CarlosG340/iot_microneedle_leaf_sensor_patch/Final Showcase.jpg

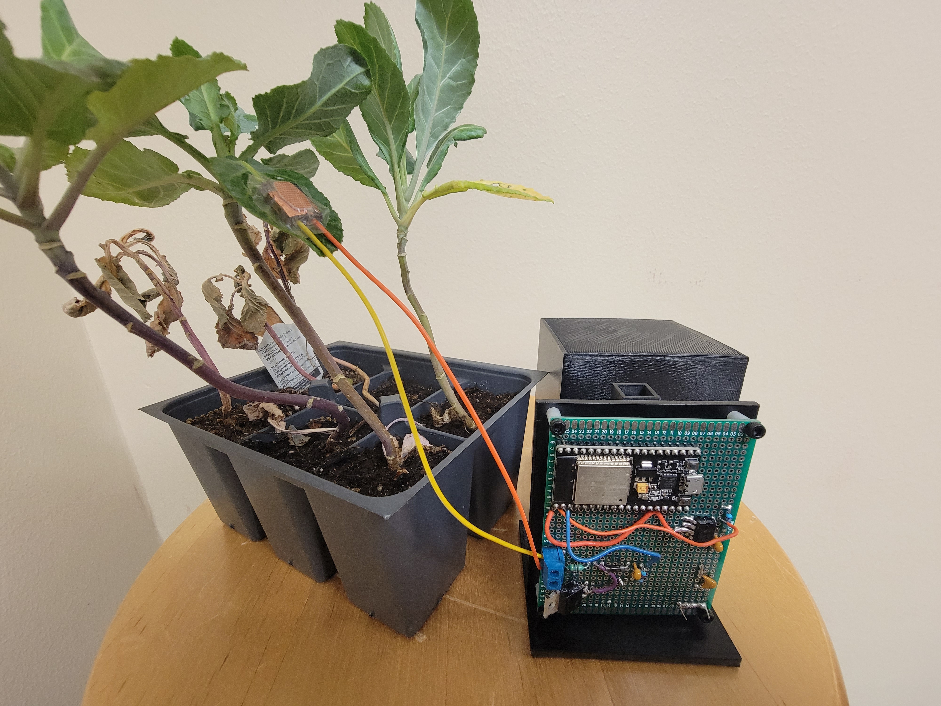
Final Showcase.jpg
