CarlosG340/iot_microneedle_leaf_sensor_patch/20220418_203752.jpg

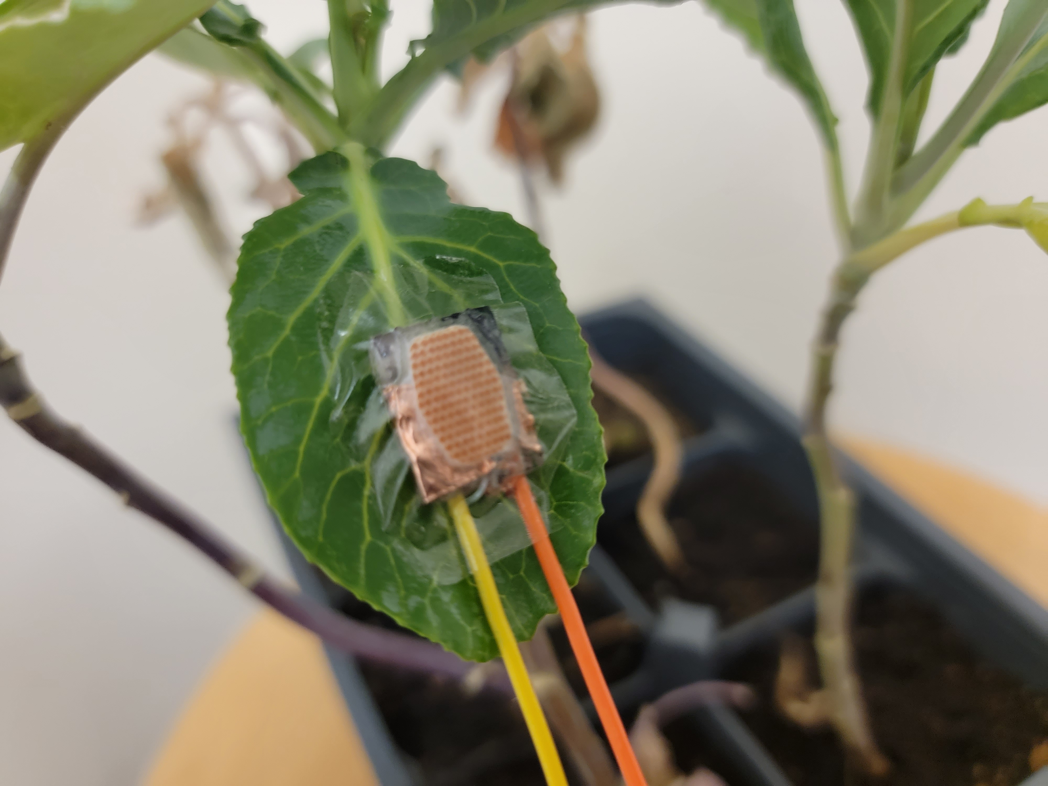
20220418_203752.jpg
