CarlosG340/iot_microneedle_leaf_sensor_patch/All_Patch_Prototype.jpg

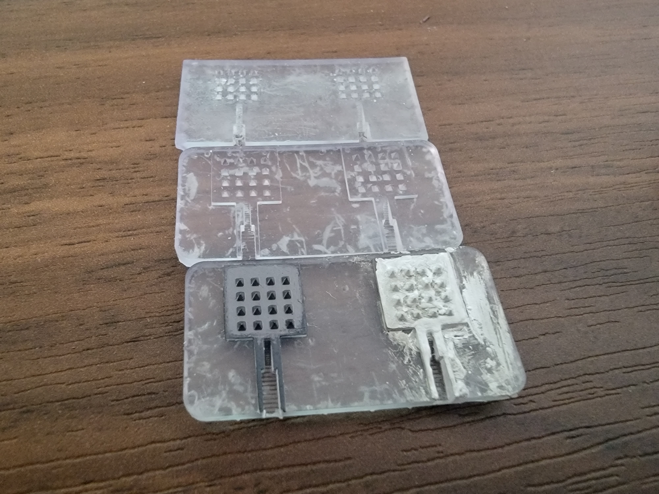
All_Patch_Prototype.jpg
