CarlosG340/iot_microneedle_leaf_sensor_patch/Patch_Prototype_1.jpg

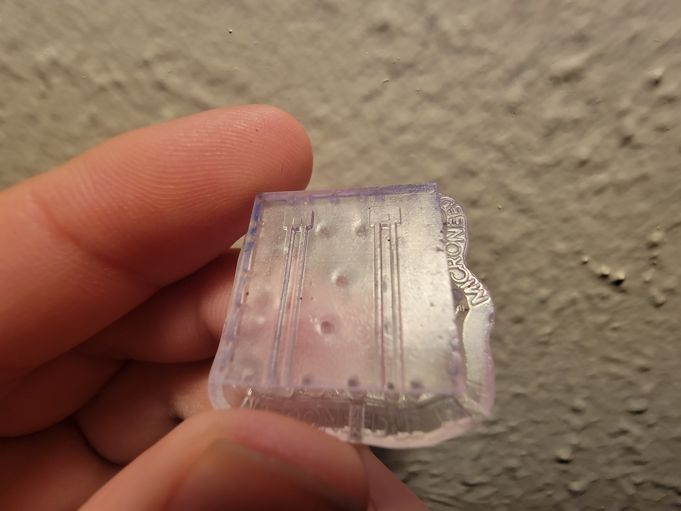
Patch_Prototype_1.jpg
