CarlosG340/iot_microneedle_leaf_sensor_patch/Patch_Prototype_2.2.jpg

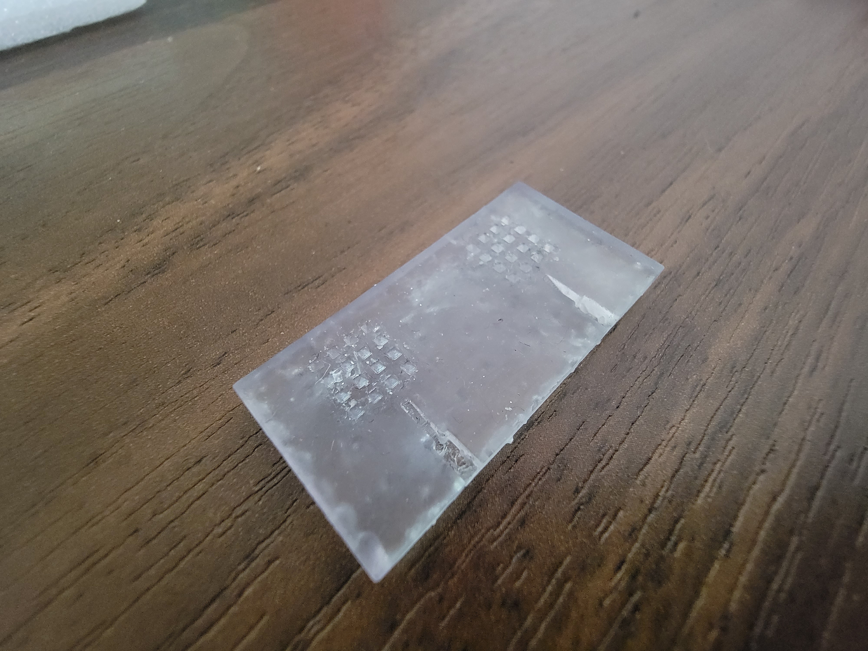
Patch_Prototype_2.2.jpg
