CarlosG340/iot_microneedle_leaf_sensor_patch/Patch_Prototyper_2.1.jpg

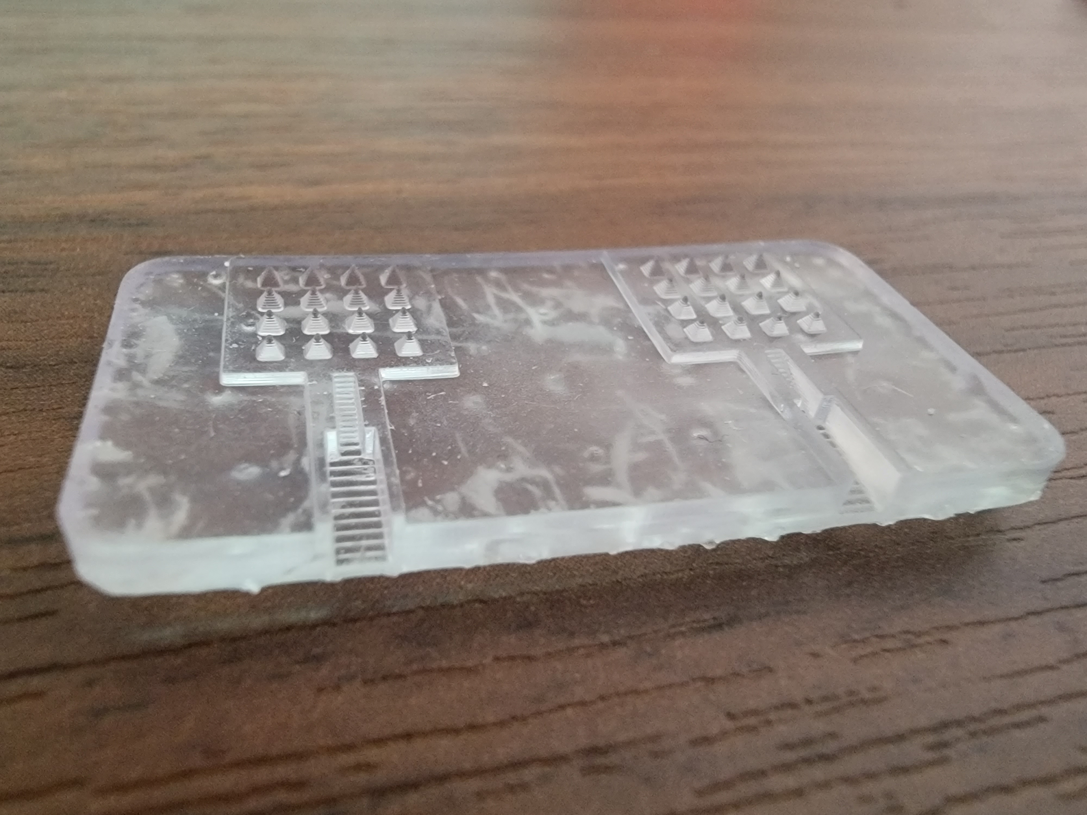
Patch_Prototyper_2.1.jpg
