CarlosG340/iot_microneedle_leaf_sensor_patch/pH_Test_Results.xlsx

Sheet: PANI Deposition
-0.199853 | -8.539962 | -8.45456238 | -8.36916276 | -8.28376314 | -8.19836352 | -8.1129639 | -9.686276 | -9.58941324 | -9.49255048 | -9.39568772 | -9.29882496 | -9.2019622 | -10.034594 | -9.93424806 | -9.83390212 | -9.73355618 | -9.63321024 | -9.5328643 | -10.242354 | -10.13993046 | -10.03750692 | -9.93508338 | -9.83265984 | -9.7302363 | -10.410912 | -10.30680288 | -10.20269376 | -10.09858464 | -9.99447552 | -9.8903664 | -10.545872 | -10.44041328 | -10.33495456 | -10.22949584 | -10.12403712 | -10.0185784 | -10.634912 | -10.52856288 | -10.42221376 | -10.31586464 | -10.20951552 | -10.1031664 | -10.723392 | -10.61615808 | -10.50892416 | -10.40169024 | -10.29445632 | -10.1872224 | -10.792832 | -10.68490368 | -10.57697536 | -10.46904704 | -10.36111872 | -10.2531904
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
