CarlosG340/iot_microneedle_leaf_sensor_patch/SecureWrite2.ino

#if defined(ESP32)
#include <WiFiMulti.h>
WiFiMulti wifiMulti;
#define DEVICE "ESP32"
#elif defined(ESP8266)
#include <ESP8266WiFiMulti.h>
ESP8266WiFiMulti wifiMulti;
#define DEVICE "ESP8266"
#endif

#include <InfluxDbClient.h>
#include <InfluxDbCloud.h>

const int numReadings = 10;

int readings[numReadings];      // the readings from the analog input
int readIndex = 0;              // the index of the current reading
int total = 0;                  // the running total
int average = 0;                // the average

int inputPin = A0;

// My stuff
int readPin=32;
int readVal;
int newReadVal;
float voltage_test1;
float finalReading;

// WiFi AP SSID
#define WIFI_SSID "Carlos wifi"
// WiFi password
#define WIFI_PASSWORD "carlos124"
// InfluxDB v2 server url, e.g. https://eu-central-1-1.aws.cloud2.influxdata.com (Use: InfluxDB UI -> Load Data -> Client Libraries)
#define INFLUXDB_URL "https://us-east-1-1.aws.cloud2.influxdata.com"
// InfluxDB v2 server or cloud API authentication token (Use: InfluxDB UI -> Load Data -> Tokens -> <select token>)
#define INFLUXDB_TOKEN "MfwFpl2KZpMjQTWujXzxpKl9Xpe4rnq-CKfn6Q5Q7EcJfvnePvWGhNHHyZ69Aq3_7SL77oDnfo2f8Whiq-mW0w=="
// InfluxDB v2 organization id (Use: InfluxDB UI -> Settings -> Profile -> <name under tile> )
#define INFLUXDB_ORG "cgalvan5@patriots.uttyler.edu"
// InfluxDB v2 bucket name (Use: InfluxDB UI -> Load Data -> Buckets)
#define INFLUXDB_BUCKET "IoT_Leaf_Sensor"

// Set timezone string according to https://www.gnu.org/software/libc/manual/html_node/TZ-Variable.html
// Examples:
//  Pacific Time: "PST8PDT"
//  Eastern: "EST5EDT"
//  Japanesse: "JST-9"
//  Central Europe: "CET-1CEST,M3.5.0,M10.5.0/3"
#define TZ_INFO "EST5EDT"

// InfluxDB client instance with preconfigured InfluxCloud certificate
InfluxDBClient client(INFLUXDB_URL, INFLUXDB_ORG, INFLUXDB_BUCKET, INFLUXDB_TOKEN, InfluxDbCloud2CACert);
// InfluxDB client instance without preconfigured InfluxCloud certificate for insecure connection 
//InfluxDBClient client(INFLUXDB_URL, INFLUXDB_ORG, INFLUXDB_BUCKET, INFLUXDB_TOKEN);

// Data point
Point sensor("IoT_Leaf_Sensor");

void setup() {
  Serial.begin(115200);
  for (int thisReading = 0; thisReading < numReadings; thisReading++) {
    readings[thisReading] = 0;

    analogSetAttenuation(ADC_11db);
  }
pinMode(readPin,INPUT);       //IoT initiation with delays for proper connectivity
           // Initialize serial and wait for port to open:
  delay(1500);                  // This delay gives the chance to wait for a Serial Monitor without blocking if none is found
  // Setup wifi
  WiFi.mode(WIFI_STA);
  wifiMulti.addAP(WIFI_SSID, WIFI_PASSWORD);

  Serial.print("Connecting to wifi");
  while (wifiMulti.run() != WL_CONNECTED) {
    Serial.print(".");
    delay(500);
  }
  Serial.println();

  // Add tags
  sensor.addTag("device", DEVICE);
  sensor.addTag("SSID", WiFi.SSID());

  // Alternatively, set insecure connection to skip server certificate validation 
  //client.setInsecure();

  // Accurate time is necessary for certificate validation and writing in batches
  // For the fastest time sync find NTP servers in your area: https://www.pool.ntp.org/zone/
  // Syncing progress and the time will be printed to Serial.
  timeSync(TZ_INFO, "pool.ntp.org", "time.nis.gov");

  // Check server connection
  if (client.validateConnection()) {
    Serial.print("Connected to InfluxDB: ");
    Serial.println(client.getServerUrl());
  } else {
    Serial.print("InfluxDB connection failed: ");
    Serial.println(client.getLastErrorMessage());
  }
}

void loop() {
  // Store measured value into point
  sensor.clearFields();
  // subtract the last reading:
  total = total - readings[readIndex];
  // read from the sensor:
  readings[readIndex] = analogRead(36);
  // add the reading to the total:
  total = total + readings[readIndex];
  // advance to the next position in the array:
  readIndex = readIndex + 1;

  // if we're at the end of the array...
  if (readIndex >= numReadings) {
    // ...wrap around to the beginning:
    readIndex = 0;

  }

  // calculate the average:
  average = total / numReadings;

  //My Stuff
  newReadVal = (5./1023.)*average;
  voltage_test1=0.3378*(newReadVal)+1.7425;
  finalReading = voltage_test1;
  Serial.println(finalReading);
  // send it to the computer as ASCII digits
  //Serial.println(average);
  delay(1);        // delay in between reads for stability
  // Report RSSI of currently connected network
 sensor.addField("voltage", finalReading);
  // Print what are we exactly writing
  Serial.print("Writing: ");
  Serial.println(client.pointToLineProtocol(sensor));
  // If no Wifi signal, try to reconnect it
  if (wifiMulti.run() != WL_CONNECTED) {
    Serial.println("Wifi connection lost");
  }
  // Write point
  if (!client.writePoint(sensor)) {
    Serial.print("InfluxDB write failed: ");
    Serial.println(client.getLastErrorMessage());
  }

  //Wait 10s
  Serial.println("Wait 1s");
  delay(1000);
}
