CarlosG340/iot_microneedle_leaf_sensor_patch/(commit log)

2022-08-16 Final Code
    Final Code containing Import/export raw data to Cloud Database. Code has description. Can be easily on Arduino IDE
2022-08-16 pH Test Results
    Excel spread sheet of final results when testing pH Level readings
    [pH_Test_Results.xlsx]
